stro1936/CWC/README.md

This folder contains information from my senior design project. The final reports, Load PCB and Turbine PCB documentation, and final turbine control code are included.
