stro1936/CWC/LoadSchematicRevF.pdf

# Power Inputs

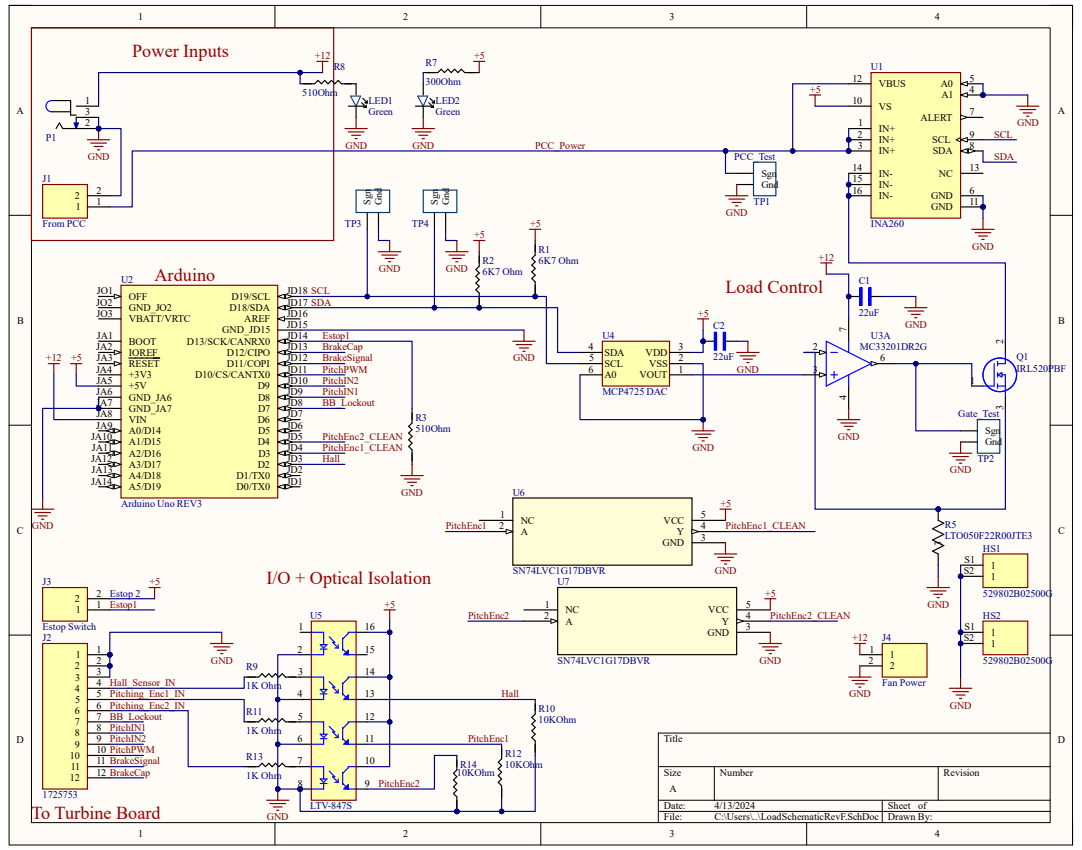
[picture p37: page 1]
