stro1936/CWC/TurbineSchematicRevC.pdf

REVISION | DESCRIPTION | DATE | APPROVED | REV. SHT. DWG. NO. 1

# Rectification & Filtering

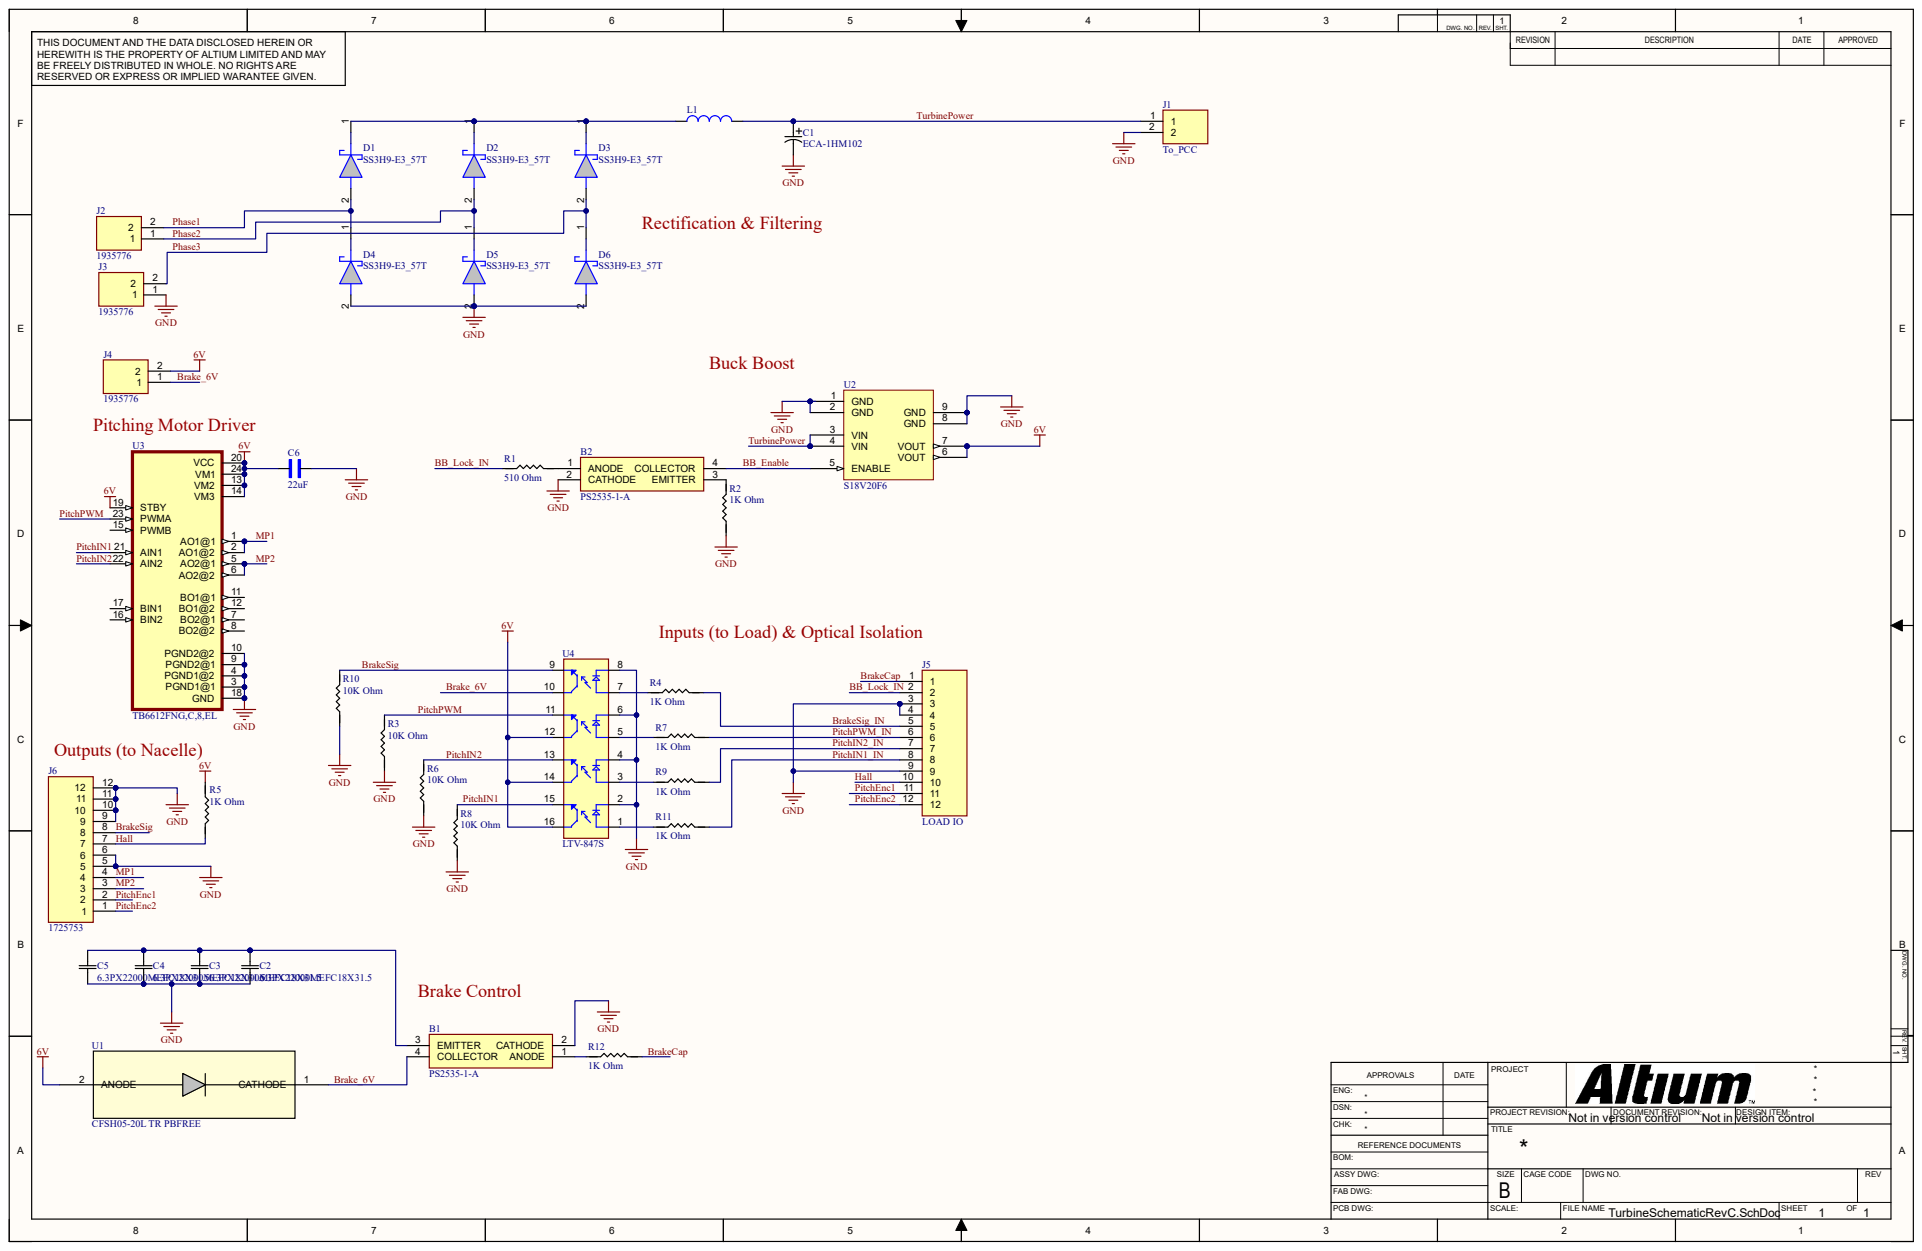
[picture p38: page 1]

8 | 7 | 6 | 5 | 4 | 3 | DWG. NO. | REV. | 1 SHT. | 2 | 1

THIS DOCUMENT AND THE DATA DISCLOSED HEREIN OR HEREWITH IS THE PROPERTY OF ALTIUM LIMITED AND MAY BE FREELY DISTRIBUTED IN WHOLE. NO RIGHTS ARE RESERVED OR EXPRESS OR IMPLIED WARANTEE GIVEN.

Inputs (to Load) & Optical Isolation

APPROVALS | DATE | PROJECT | * *

ENG: *
CHK: * | | TITLE *

DSN: * | | PROJECT REVISION: | DOCUMENT REVISION: Not in version control | DESIGN ITEM: Not in version control
