stro1936/CWC/LoadLayoutRevF.pdf

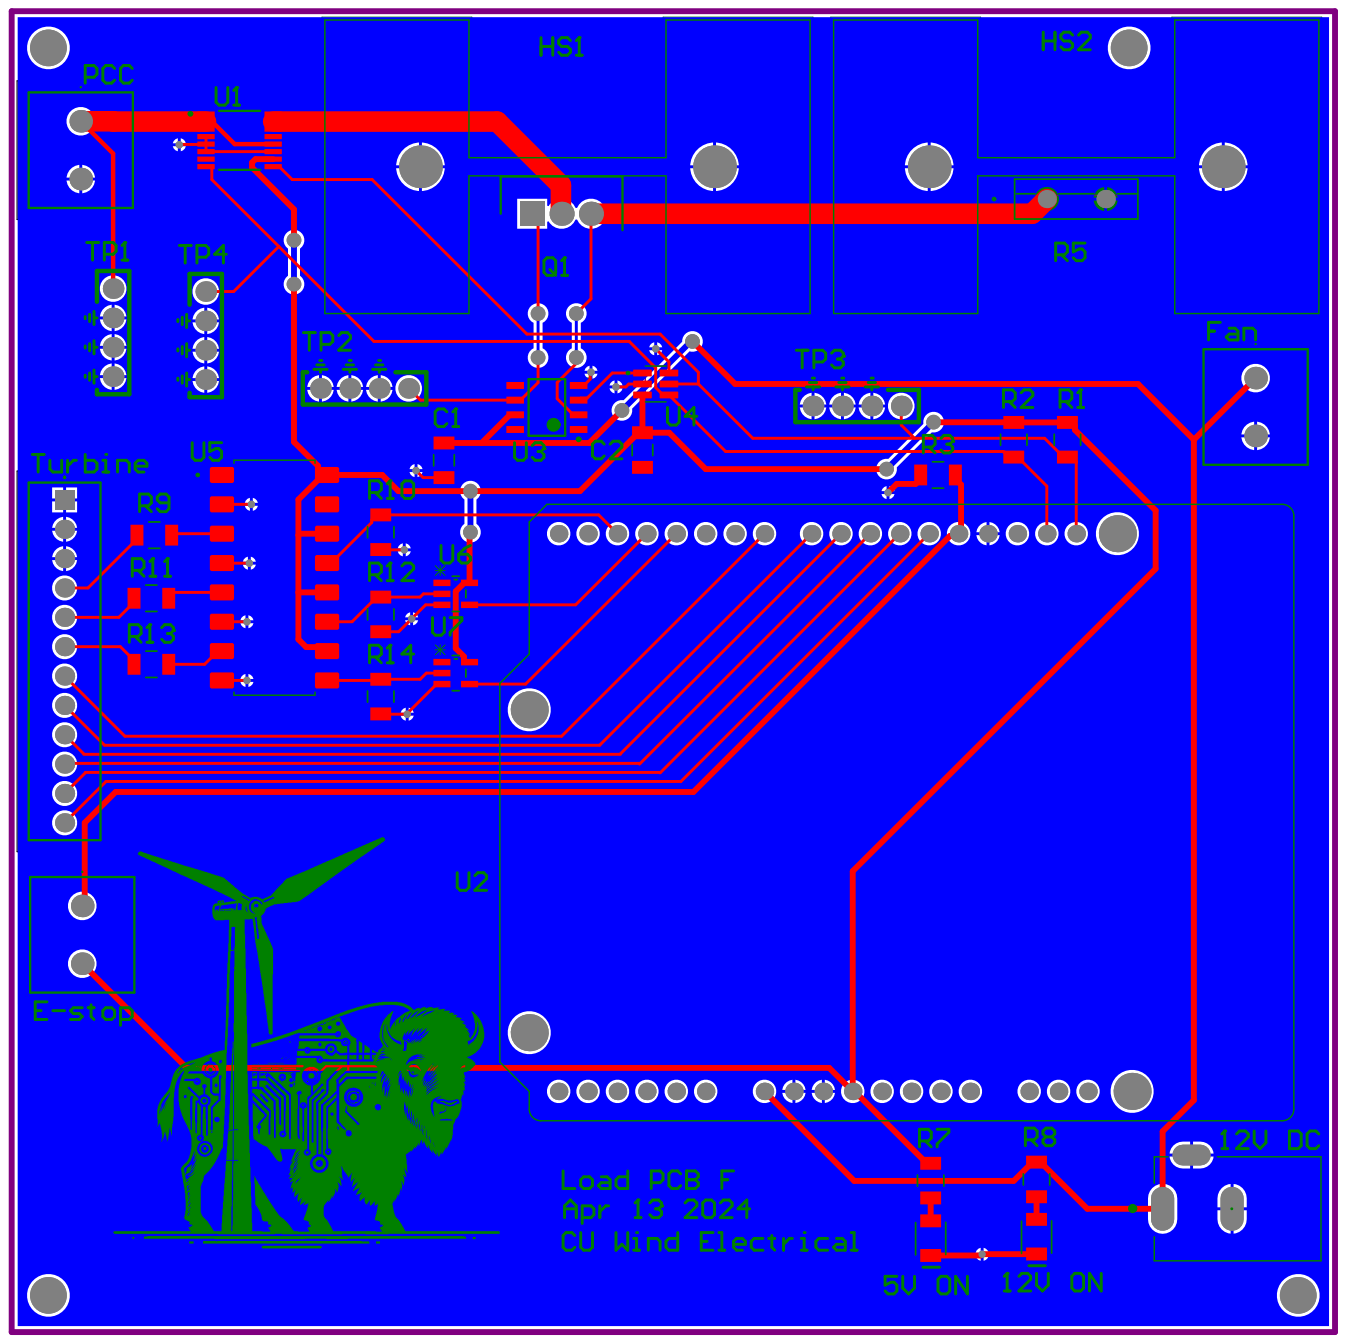
[picture p39: page 1]
