stro1936/CWC/TurbineLayoutRevC.pdf

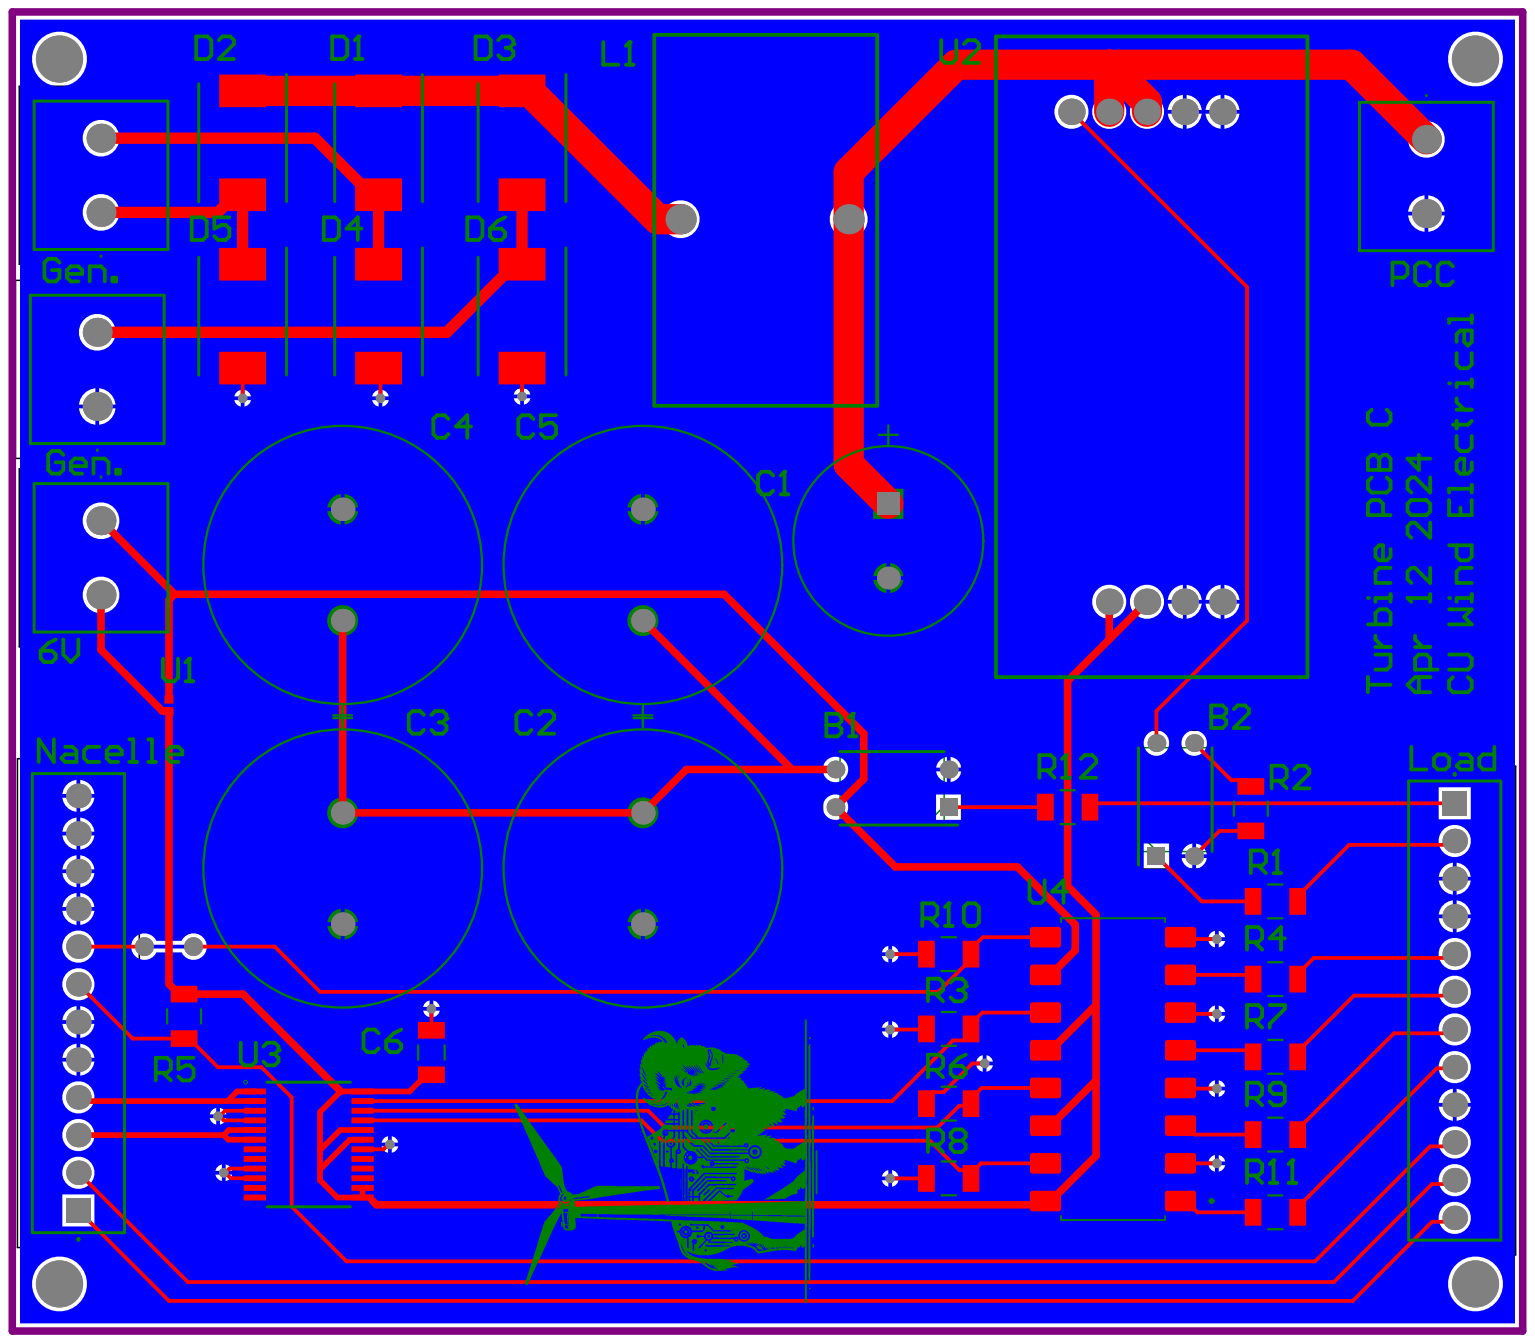
[picture p40: page 1]
