stro1936/CWC/Full System OLD.pdf

# Full System OLD

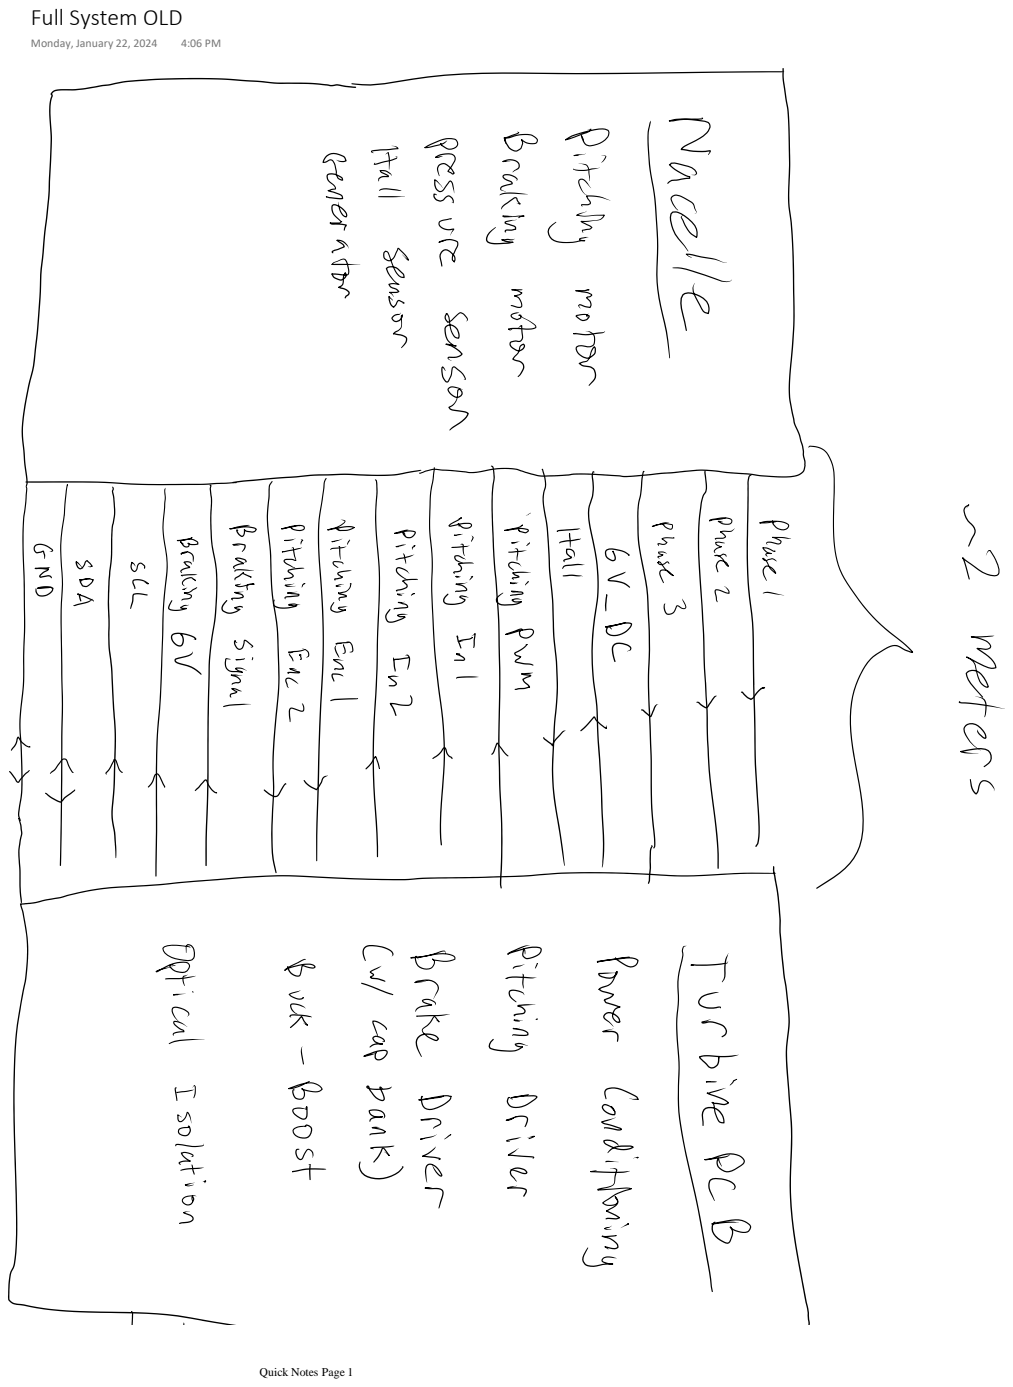
[picture p41: page 1]
Monday, January 22, 2024

Quick Notes Page 1

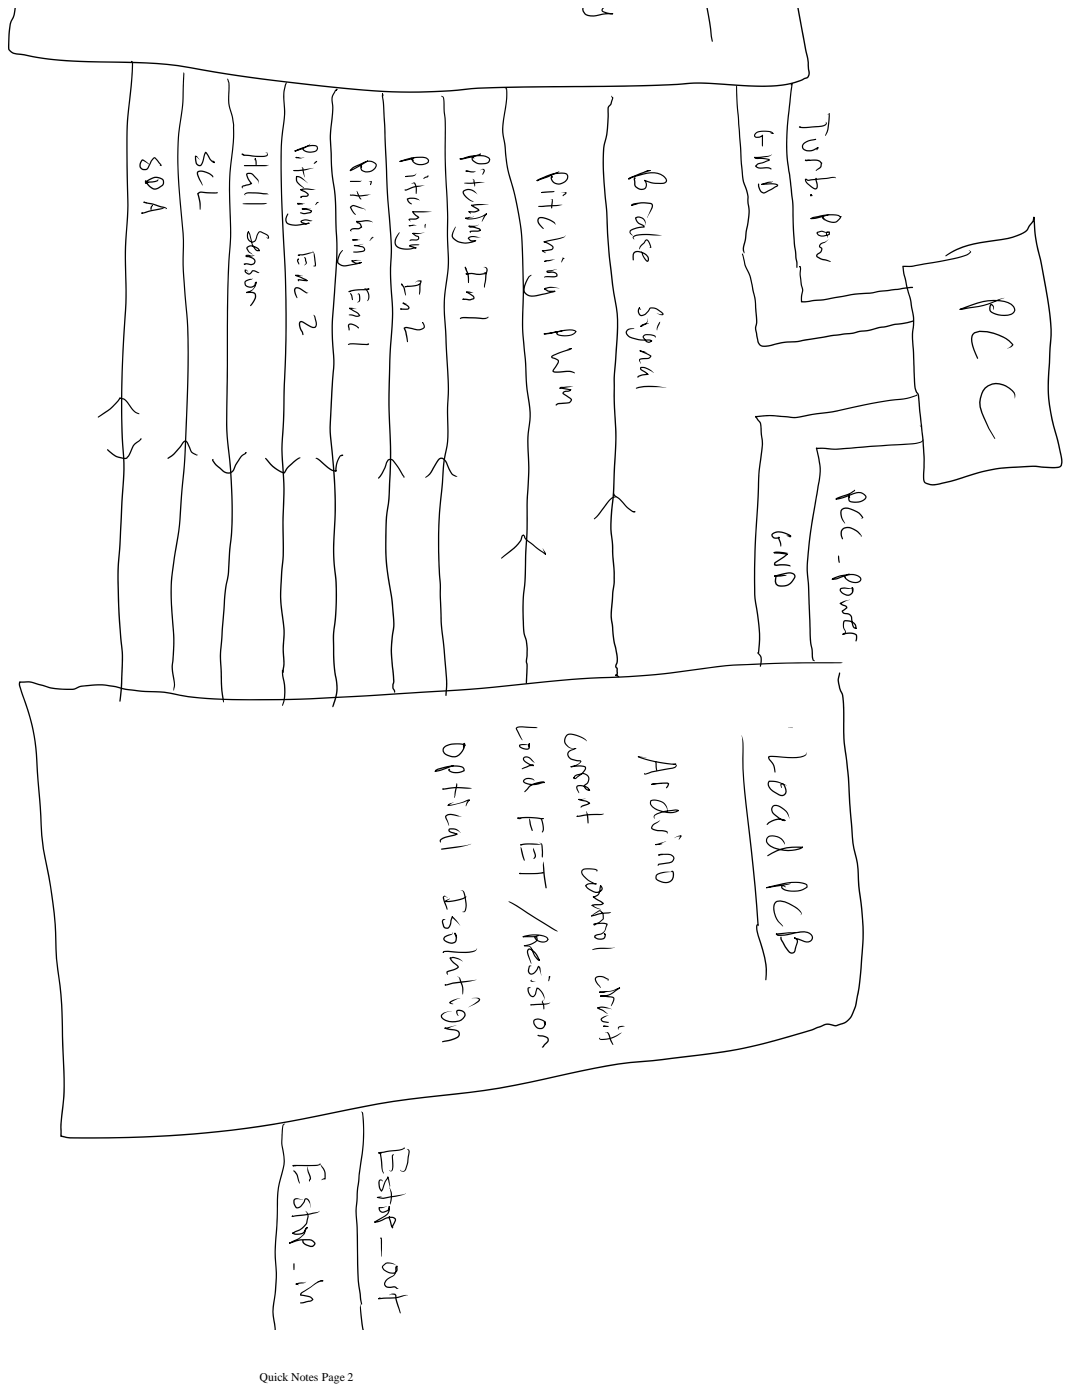
[picture p42: page 2]

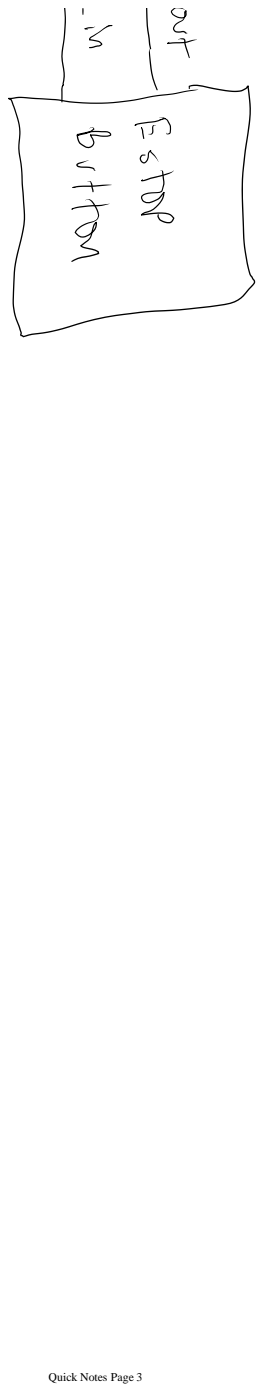
[picture p43: page 3]
